Sicatriz/Soldeerstation_PCB/FOTOS/IMG_7382-min.jpg

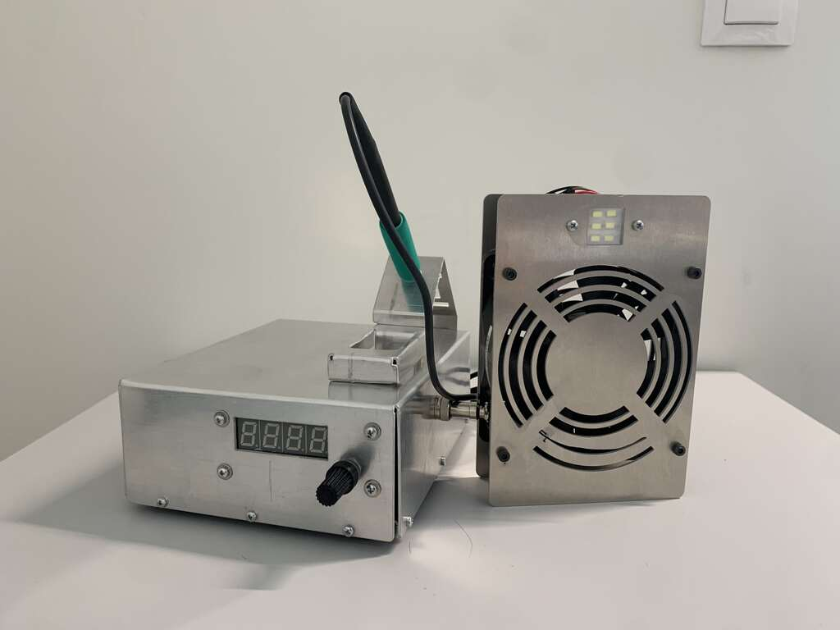
FOTOS/IMG_7382-min.jpg
