Sicatriz/Soldeerstation_PCB/FOTOS/IMG_7384-min.jpg

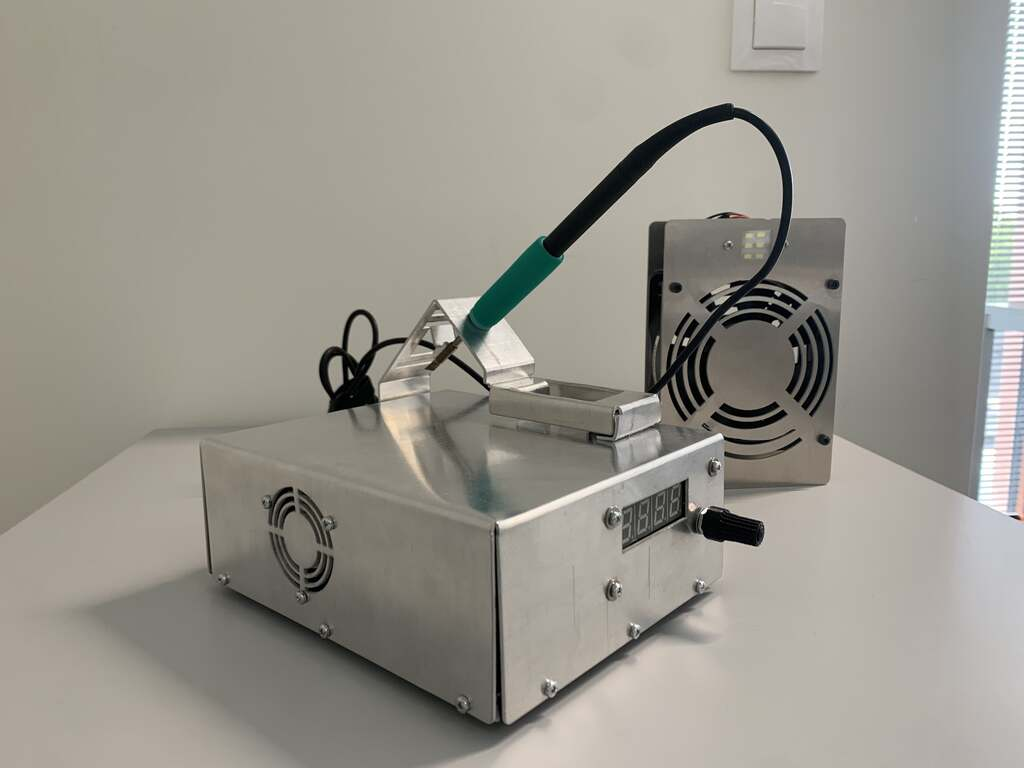
FOTOS/IMG_7384-min.jpg
