Sicatriz/Soldeerstation_PCB/FOTOS/IMG_7383-min.jpg

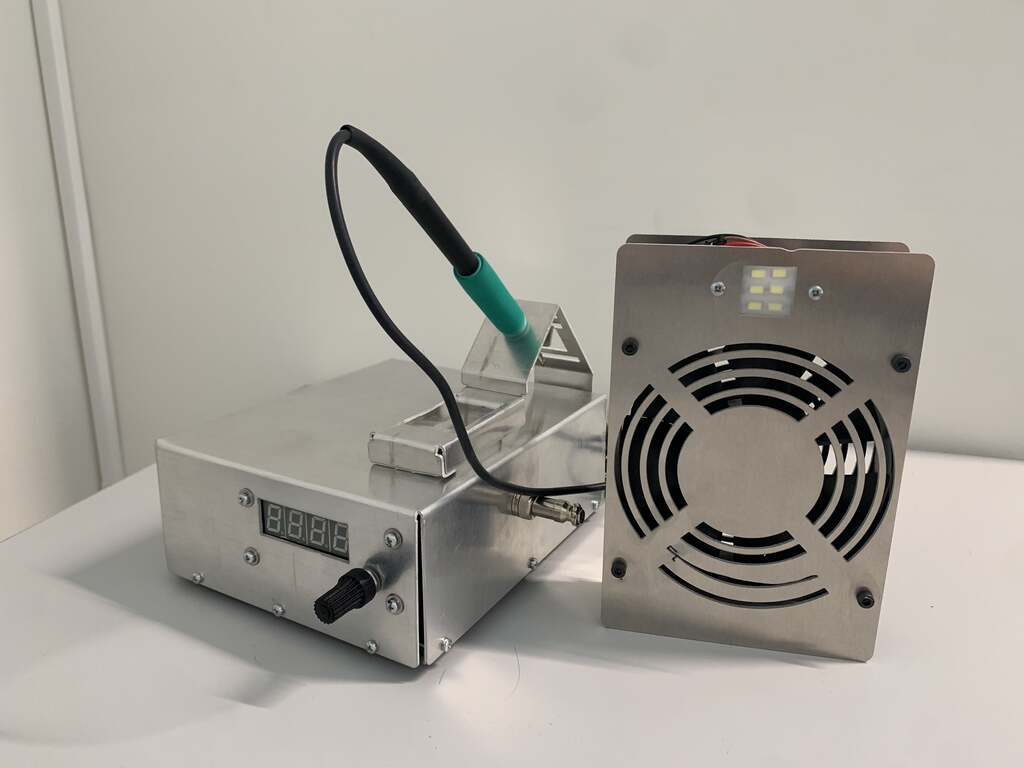
FOTOS/IMG_7383-min.jpg
