Sicatriz/Soldeerstation_PCB/FOTOS/IMG_7385-min.jpg

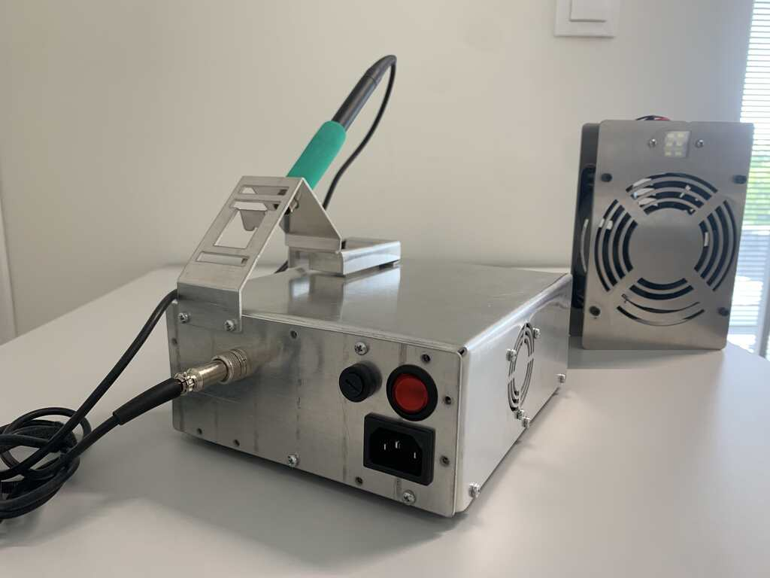
FOTOS/IMG_7385-min.jpg
