Sicatriz/Soldeerstation_PCB/DisplayPrintFINAL.step

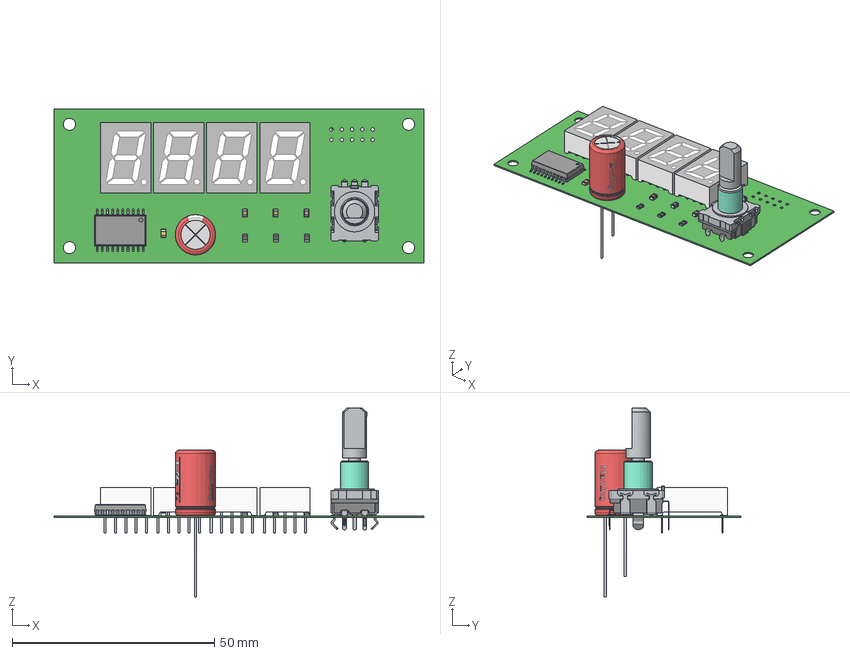
[picture p11: CAD file, 2022-05-05]
DisplayPrintFINAL.step
91.4 x 38.1 x 46.6 mm
pin x 3
pin_short x 2
contact_plate
Extruded
PinsArrayLR
Housing x 4
PCB x 4
Glue x 4
Open_CASCADE_STEP_translator_6.8_14.1.1
Open_CASCADE_STEP_translator_6.8_14.1.2
Open_CASCADE_STEP_translator_6.8_14.2.1
10x16x5x0.6 x 3
