Sicatriz/Soldeerstation_PCB/LedPrintFINAL.step

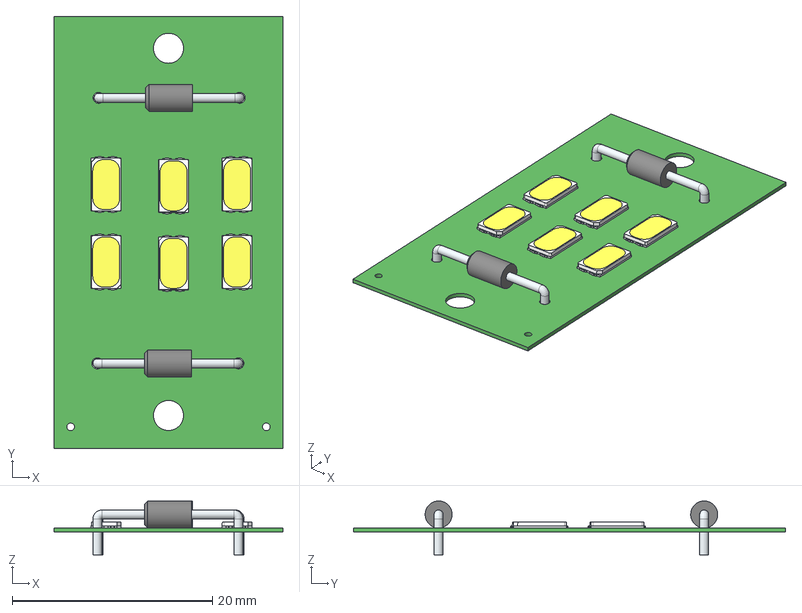
[picture p12: CAD file, 2022-05-05]
LedPrintFINAL.step
22.9 x 43.2 x 5.40 mm
Pins x 6
Dome x 6
Glue x 6
