Sicatriz/Soldeerstation_PCB/(list of files, cad)

Other CAD files:
LedPrintV4.step
DisplayPrint.step
