Sicatriz/Soldeerstation_PCB/(list of files, drawings)

Other design files:
Display.SchDoc
DisplayPrint.PcbDoc
Led.SchDoc
LedPrintV4.PcbDoc
LedRond.PcbDoc
MainIC.SchDoc
NewPrintMainV3.PcbDoc
PO_Soldeerstation.PrjPcb
PO_SS_Lib.PcbLib
PO_SS_Lib.SchLib
Regelaar.SchDoc
Versterker.SchDoc
Voeding.SchDoc
