Sicatriz/Soldeerstation_PCB/(commit log)

2022-05-05 Add files via upload
    upload start
    [Display.SchDoc, DisplayPrint.PcbDoc, DisplayPrint.step, DisplayPrintFINAL.step, Led.SchDoc, LedPrintFINAL.step, LedPrintV4.PcbDoc, LedPrintV4.step]
2022-05-05 upload folders
    [DisplayPrint_Copper_Signal_Bot.gbr, DisplayPrint_Copper_Signal_Top.gbr, DisplayPrint_Drawing_1.gbr, DisplayPrint_Drillmap_1.gbr, DisplayPrint_Keep-out.gbr, DisplayPrint_Legend_Bot.gbr, DisplayPrint_Legend_Top.gbr, DisplayPrint_Mechanical_1.gbr]
